TikitaTolley/ai-boo/media/cad-and-electronics.webp

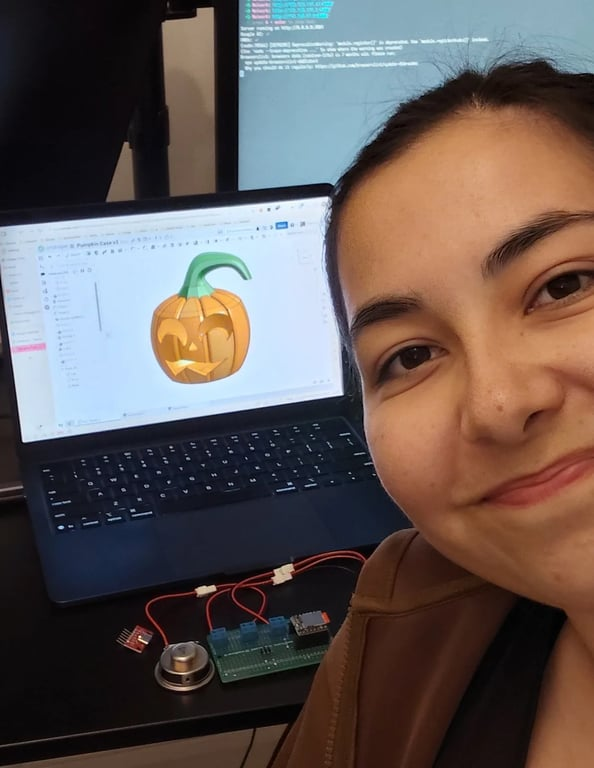
media/cad-and-electronics.webp
