TikitaTolley/ai-boo/print/pumpkin-boo.3mf

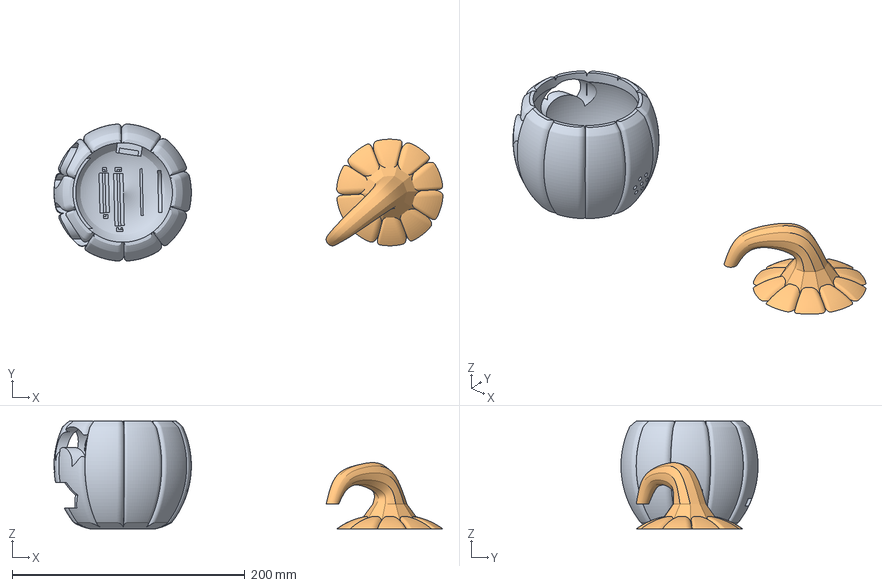
[picture p6: CAD file, 2026-11-01]
print/pumpkin-boo.3mf
333.9 x 117.7 x 92.7 mm
pumpkin-bowl-v5.stl
pumpkin boo lid v1.stl
