TikitaTolley/ai-boo/print/pumpkin-bowl.stl

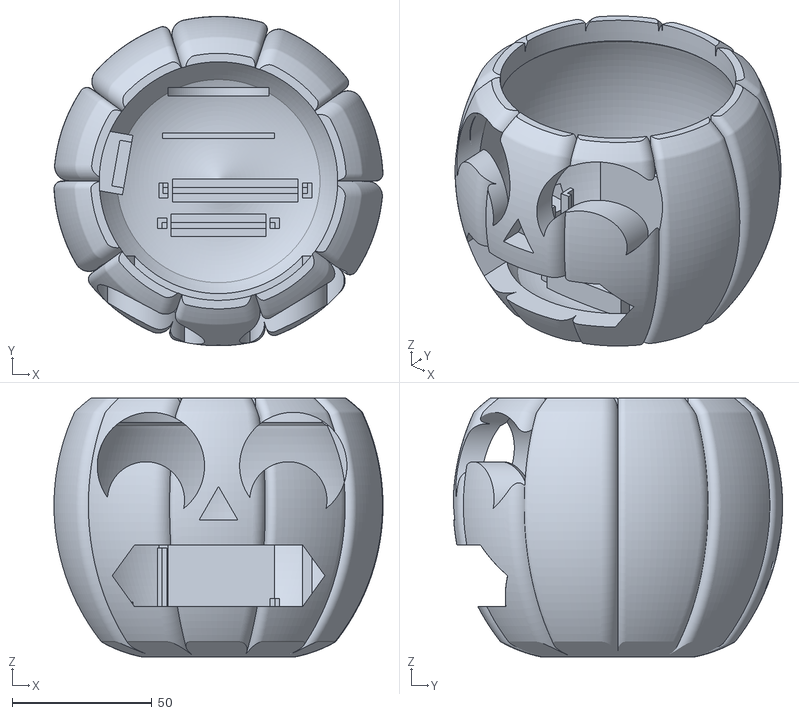
[picture p7: CAD file, 2026-11-01]
print/pumpkin-bowl.stl
117.8 x 117.9 x 92.7
