TikitaTolley/ai-boo/print/pumpkin-lid.stl

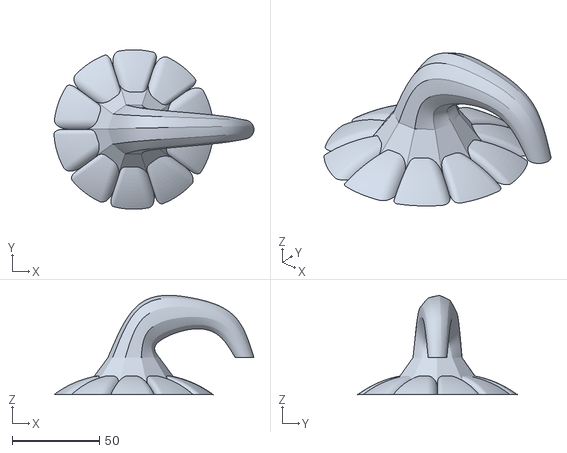
[picture p8: CAD file, 2026-11-01]
print/pumpkin-lid.stl
114.8 x 91.5 x 57.0
