TikitaTolley/ai-boo/media/printing-the-bowl.webp

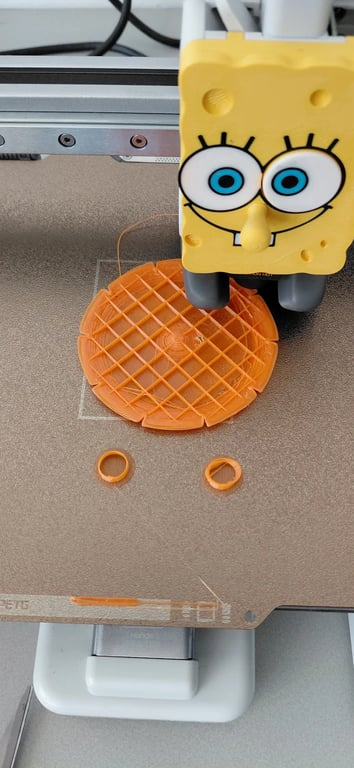
media/printing-the-bowl.webp
