TikitaTolley/ai-boo/main/secrets.example.h

#pragma once
#define WIFI_SSID "YOUR_WIFI_NAME"
#define WIFI_PASSWORD "YOUR_WIFI_PASSWORD"
// A second network (optional)
#define HOTSPOT_SSID "YOUR_HOTSPOT_NAME"
#define HOTSPOT_PASSWORD "YOUR_HOTSPOT_PASSWORD"
// Password for uploading over Wi-Fi
#define OTA_PASSWORD "CHOOSE_A_PASSWORD"
// Password for the web pages (user name: boo). Required.
#define PAGE_PASSWORD "CHOOSE_A_PASSWORD"
