TikitaTolley/ai-boo/(commit log)

2026-10-06 Organise Halloween builds into Boo Pumpkin and Haunted Sweet Bowl
2026-10-29 person detection on the esp32-cam, drop camera web server example
2026-10-30 pumpkin boo: status page, phone tool, readme, photos
2026-10-30 add diylc board layout
2026-10-30 board layout image, capacitor in parts list
2026-10-31 readme: circuit to pumpkin and boo test videos
2026-11-01 enclosure stls and print settings
2026-11-01 full printables link
2026-11-01 parts: 3 jst pairs, jumper wires, 5 terminals
